rcls/monitor/clocky.kicad_pcb

## KiCad design clocky.kicad_pcb (2025-12-03)

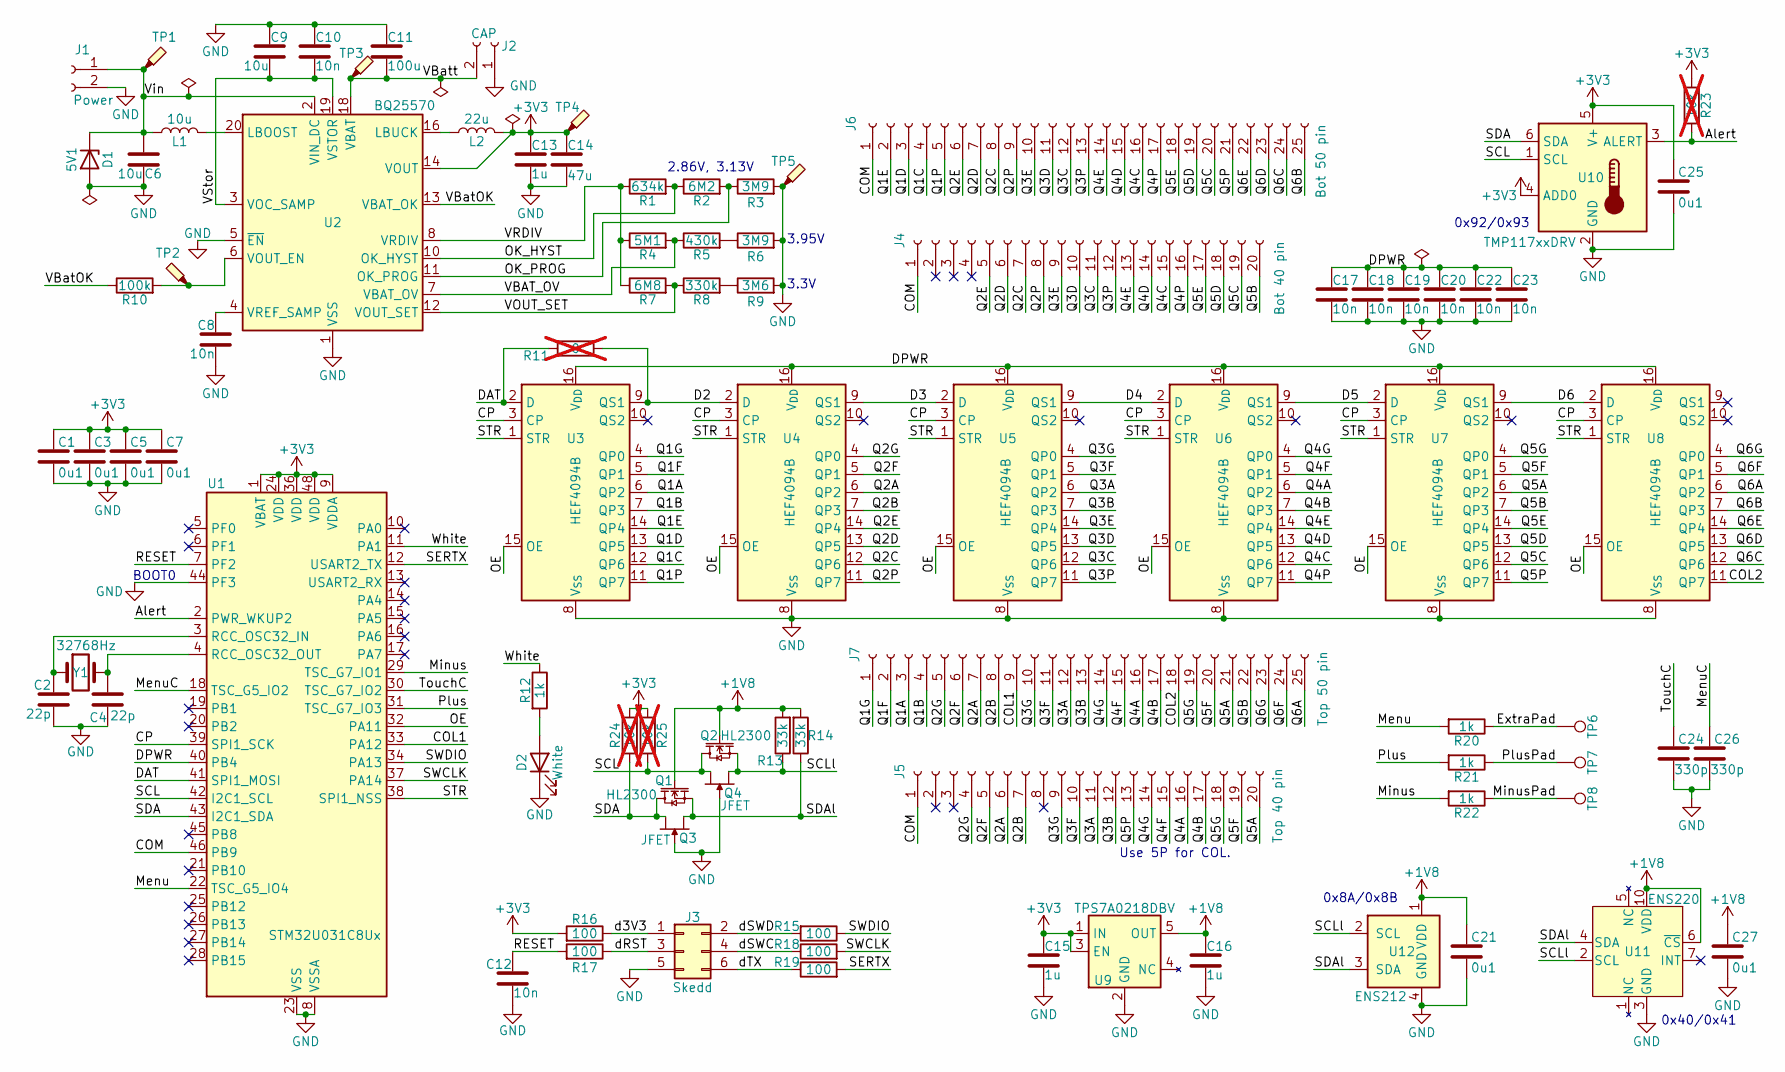
[picture p1: schematic clocky.kicad_sch]

Parts:
C1, C3, C5, C7, C21, C25, C27: 0u1; C_0402_1005Metric; JLCPCB C307331
C2, C4: 22p; C_0402_1005Metric; JLCPCB C1555
C6, C9: 10u; C_0603_1608Metric; JLCPCB C19702
C8, C10, C12, C17, C18, C19, C20, C22, C23: 10n; C_0402_1005Metric; JLCPCB C15195
C11: 100u; C_1206_3216Metric; JLCPCB C15008
C13, C15, C16: 1u; C_0402_1005Metric; JLCPCB C52923
C14: 47u; C_0805_2012Metric; JLCPCB C16780
C24, C26: 330p; C_0402_1005Metric; JLCPCB C13533
D1: 5V1; D_SOD-323; JLCPCB C19077434
D2: White; LED_0603_1608Metric; JLCPCB C2290
J1: Power; PinSocket_1x02_P2.54mm_Vertical
J2: CAP; TwoPin_P3.5mm
J3: Skedd; Skedd6
J4: Bot 40 pin; PinSocket_1x20_P2.54mm_Vertical
J5: Top 40 pin; PinSocket_1x20_P2.54mm_Vertical
J6: Bot 50 pin; PinHeader_1x25_P2.54mm_Vertical
J7: Top 50 pin; PinHeader_1x25_P2.54mm_Vertical
L1: 10u; L_0805_2012Metric_Pad1.05x1.20mm_HandSolder
L2: 22u; L_0805_2012Metric_Pad1.05x1.20mm_HandSolder
Q1, Q2: HL2300; SOT-23; JLCPCB C7420343
Q3, Q4: JFET; SOT-23-3
R1: 634k; R_0603_1608Metric
R2: 6M2; R_0603_1608Metric
R3, R6: 3M9; R_0603_1608Metric
R4: 5M1; R_0603_1608Metric
R5: 430k; R_0603_1608Metric; JLCPCB C25969
R7: 6M8; R_0603_1608Metric
R8: 330k; R_0603_1608Metric; JLCPCB C23137
R9: 3M6; R_0603_1608Metric
R10: 100k; R_0402_1005Metric; JLCPCB C25741
R11: 0; R_0603_1608Metric; not fitted
R12, R20, R21, R22: 1k; R_0402_1005Metric; JLCPCB C11702
R13, R14: 33k; R_0603_1608Metric; JLCPCB C4216
R15, R16, R17, R18, R19: 100; R_0402_1005Metric; JLCPCB C25076
R23, R24, R25: 10k; R_0603_1608Metric; not fitted
TP1, TP2, TP3, TP4, TP5: TestPoint_Probe; TestPoint
TP6, TP7, TP8: TestPoint; Dummy
U1: STM32U031C8Ux; QFN-48-1EP_7x7mm_P0.5mm_EP5.6x5.6mm
U2: BQ25570; QFN-20-1EP_3.5x3.5mm_P0.5mm_EP2x2mm; JLCPCB C506250
U3, U4, U5, U6, U7, U8: HEF4094B; SOIC-16_3.9x9.9mm_P1.27mm
U9: TPS7A0218DBV; SOT-23-5; JLCPCB C3748843
U10: TMP117xxDRV; WSON-6-1EP_2x2mm_P0.65mm_NoEP; JLCPCB C699536
U11: ENS220
U12: ENS212; AMS_QFN-4-1EP_2x2mm_P0.95mm_EP0.7x1.6mm
Y1: 32768Hz; Crystal_SMD_3215-2Pin_3.2x1.5mm; JLCPCB C32346

Connections:
+1V8: C16.1, C21.1, C27.1, Q1.1 (G), Q2.1 (G), R13.2, R14.2, U9.5 (OUT), U11.6 (~CS), U11.10 (VDD), U12.1 (VDD)
+3V3: C1.1, C3.1, C5.1, C7.1, C13.1, C14.1, C15.1, C25.1, L2.2, R16.2, R23.2, R24.2, R25.2, TP4.1, U1.1 (VBAT), U1.9 (VDDA), U1.24 (VDD), U1.36 (VDD), U1.48 (VDD), U2.14 (VOUT), U9.1 (IN), U9.3 (EN), U10.4 (ADD0), U10.5 (V+)
/Alert: R23.1, U1.2 (PWR_WKUP2), U10.3 (ALERT)
/COL1: J7.9, U1.33 (PA12)
/COL2: J7.18, U8.11 (QP7)
/COM: J4.1, J5.1, J6.1, U1.46 (PB9)
/CP: U1.39 (SPI1_SCK), U3.3 (CP), U4.3 (CP), U5.3 (CP), U6.3 (CP), U7.3 (CP), U8.3 (CP)
/D2: R11.2, U3.9 (QS1), U4.2 (D)
/D3: U4.9 (QS1), U5.2 (D)
/D4: U5.9 (QS1), U6.2 (D)
/D5: U6.9 (QS1), U7.2 (D)
/D6: U7.9 (QS1), U8.2 (D)
/DAT: R11.1, U1.41 (SPI1_MOSI), U3.2 (D)
/DPWR: C17.1, C18.1, C19.1, C20.1, C22.1, C23.1, U1.40 (PB4), U3.16 (V_{DD}), U4.16 (V_{DD}), U5.16 (V_{DD}), U6.16 (V_{DD}), U7.16 (V_{DD}), U8.16 (V_{DD})
/ExtraPad: R20.1, TP6.1
/Menu: R20.2, U1.22 (TSC_G5_IO4)
/MenuC: C26.1, U1.18 (TSC_G5_IO2)
/Minus: R22.2, U1.29 (TSC_G7_IO1)
/MinusPad: R22.1, TP8.1
/OE: U1.32 (PA11), U3.15 (OE), U4.15 (OE), U5.15 (OE), U6.15 (OE), U7.15 (OE), U8.15 (OE)
/OK_HYST: R1.2, R2.1, U2.10 (OK_HYST)
/OK_PROG: R2.2, R3.1, U2.11 (OK_PROG)
/Plus: R21.2, U1.31 (TSC_G7_IO3)
/PlusPad: R21.1, TP7.1
/Q1A: J7.3, U3.6 (QP2)
/Q1B: J7.4, U3.7 (QP3)
/Q1C: J6.4, U3.12 (QP6)
/Q1D: J6.3, U3.13 (QP5)
/Q1E: J6.2, U3.14 (QP4)
/Q1F: J7.2, U3.5 (QP1)
/Q1G: J7.1, U3.4 (QP0)
/Q1P: J6.5, U3.11 (QP7)
/Q2A: J5.6, J7.7, U4.6 (QP2)
/Q2B: J5.7, J7.8, U4.7 (QP3)
/Q2C: J4.7, J6.8, U4.12 (QP6)
/Q2D: J4.6, J6.7, U4.13 (QP5)
/Q2E: J4.5, J6.6, U4.14 (QP4)
/Q2F: J5.5, J7.6, U4.5 (QP1)
/Q2G: J5.4, J7.5, U4.4 (QP0)
/Q2P: J4.8, J6.9, U4.11 (QP7)
/Q3A: J5.11, J7.12, U5.6 (QP2)
/Q3B: J5.12, J7.13, U5.7 (QP3)
/Q3C: J4.11, J6.12, U5.12 (QP6)
/Q3D: J4.10, J6.11, U5.13 (QP5)
/Q3E: J4.9, J6.10, U5.14 (QP4)
/Q3F: J5.10, J7.11, U5.5 (QP1)
/Q3G: J5.9, J7.10, U5.4 (QP0)
/Q3P: J4.12, J6.13, U5.11 (QP7)
/Q4A: J5.16, J7.16, U6.6 (QP2)
/Q4B: J5.17, J7.17, U6.7 (QP3)
/Q4C: J4.15, J6.16, U6.12 (QP6)
/Q4D: J4.14, J6.15, U6.13 (QP5)
/Q4E: J4.13, J6.14, U6.14 (QP4)
/Q4F: J5.15, J7.15, U6.5 (QP1)
/Q4G: J5.14, J7.14, U6.4 (QP0)
/Q4P: J4.16, J6.17, U6.11 (QP7)
/Q5A: J5.20, J7.21, U7.6 (QP2)
/Q5B: J4.20, J7.22, U7.7 (QP3)
/Q5C: J4.19, J6.20, U7.12 (QP6)
/Q5D: J4.18, J6.19, U7.13 (QP5)
/Q5E: J4.17, J6.18, U7.14 (QP4)
/Q5F: J5.19, J7.20, U7.5 (QP1)
/Q5G: J5.18, J7.19, U7.4 (QP0)
/Q5P: J5.13, J6.21, U7.11 (QP7)
/Q6A: J7.25, U8.6 (QP2)
/Q6B: J6.25, U8.7 (QP3)
/Q6C: J6.24, U8.12 (QP6)
/Q6D: J6.23, U8.13 (QP5)
/Q6E: J6.22, U8.14 (QP4)
/Q6F: J7.24, U8.5 (QP1)
/Q6G: J7.23, U8.4 (QP0)
/RESET: C12.1, R17.2, U1.7 (PF2)
/SCL: Q2.3 (D), Q4.2 (S), R25.1, U1.42 (I2C1_SCL), U10.1 (SCL)
/SCLl: Q2.2 (S), Q4.1 (D), R13.1, U11.2 (SCL), U12.2 (SCL)
/SDA: Q1.3 (D), Q3.1 (D), R24.1, U1.43 (I2C1_SDA), U10.6 (SDA)
/SDAl: Q1.2 (S), Q3.2 (S), R14.1, U11.4 (SDA), U12.3 (SDA)
/SERTX: R19.2, U1.12 (USART2_TX)
/STR: U1.38 (SPI1_NSS), U3.1 (STR), U4.1 (STR), U5.1 (STR), U6.1 (STR), U7.1 (STR), U8.1 (STR)
/SWCLK: R18.2, U1.37 (PA14)
/SWDIO: R15.1, U1.34 (PA13)
/TouchC: C24.1, U1.30 (TSC_G7_IO2)
/VBAT_OV: R4.2, R5.1, U2.7 (VBAT_OV)
/VBatOK: R10.1, U2.13 (VBAT_OK)
/VBatt: C11.2, J2.2, TP3.1, U2.18 (VBAT)
/VOUT_SET: R7.2, R8.1, U2.12 (VOUT_SET)
/VRDIV: R1.1, R4.1, R7.1, U2.8 (VRDIV)
/VStor: C9.2, C10.2, U2.3 (VOC_SAMP), U2.19 (VSTOR)
/Vin: C6.1, D1.1 (K), J1.1, L1.1, TP1.1, U2.2 (VIN_DC)
/White: R12.1, U1.11 (PA1)
/d3V3: J3.1, R16.1
/dRST: J3.3, R17.1
/dSWC: J3.4, R18.1
/dSWD: J3.2, R15.2
/dTX: J3.6, R19.1
GND: C1.2, C2.2, C3.2, C4.2, C5.2, C6.2, C7.2, C8.2, C9.1, C10.1, C11.1, C12.2, C13.2, C14.2, C15.2, C16.2, C17.2, C18.2, C19.2, C20.2, C21.2, C22.2, C23.2, C24.2, C25.2, C26.2, C27.2, D1.2 (A), D2.1 (K), J1.2, J2.1, J3.5, Q3.3 (G), Q4.3 (G), R3.2, R6.2, R9.2, TP5.1, U1.8 (VSSA), U1.23 (VSS), U1.35 (VSS), U1.44 (PF3), U1.47 (VSS), U1.49 (VSS), U2.1 (VSS), U2.5 (~EN), U2.9 (VSS), U2.15 (VSS), U2.17 (VSS), U2.21 (VSS), U3.8 (V_{SS}), U4.8 (V_{SS}), U5.8 (V_{SS}), U6.8 (V_{SS}), U7.8 (V_{SS}), U8.8 (V_{SS}), U9.2 (GND), U10.2 (GND), U11.3 (GND), U11.8 (GND), U11.9 (GND), U12.4 (GND), U12.5 (GND)
unnamed: D2.2 (A), R12.2
unnamed: R5.2, R6.1
unnamed: R8.2, R9.1
unnamed: C2.1, U1.3 (RCC_OSC32_IN), Y1.1
unnamed: C4.1, U1.4 (RCC_OSC32_OUT), Y1.2
unnamed: L1.2, U2.20 (LBOOST)
unnamed: L2.1, U2.16 (LBUCK)
unnamed: R10.2, TP2.1, U2.6 (VOUT_EN)
unnamed: C8.1, U2.4 (VREF_SAMP)

Notes on the sheet:
3.95V
3.3V
0x8A/0x8B
BOOT0
2.86V, 3.13V
0x40/0x41
Use 5P for COL.
0x92/0x93

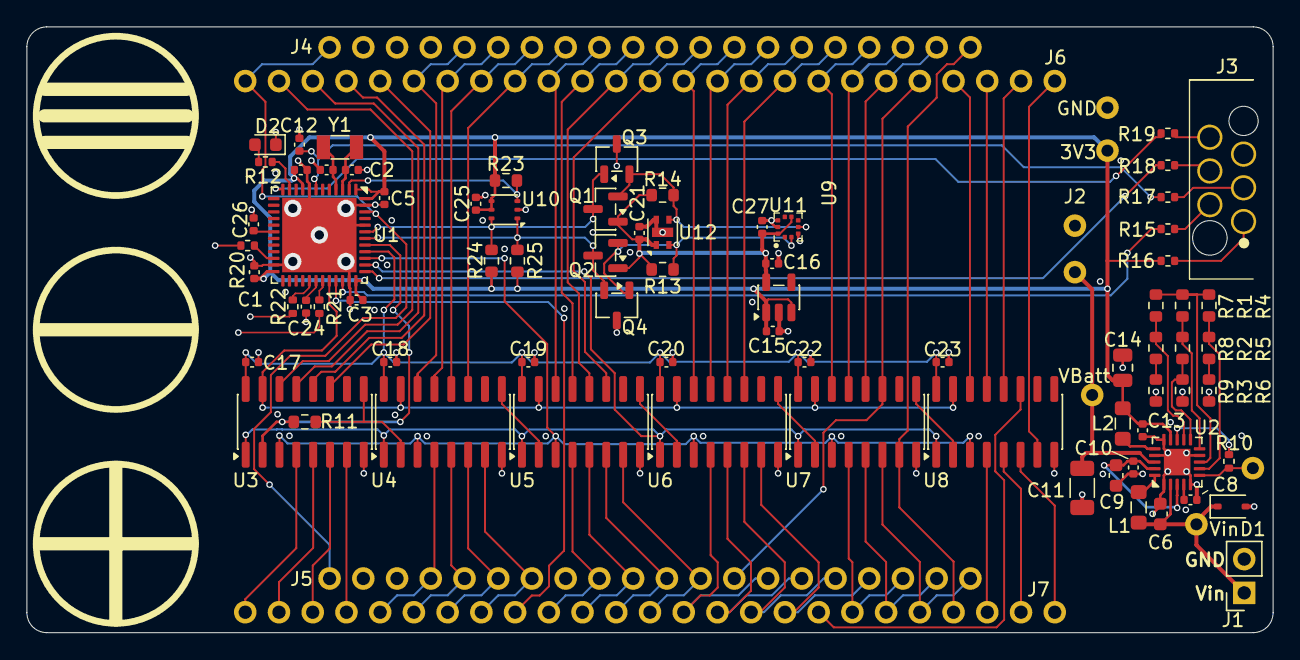
[picture p2: board clocky.kicad_pcb from above]

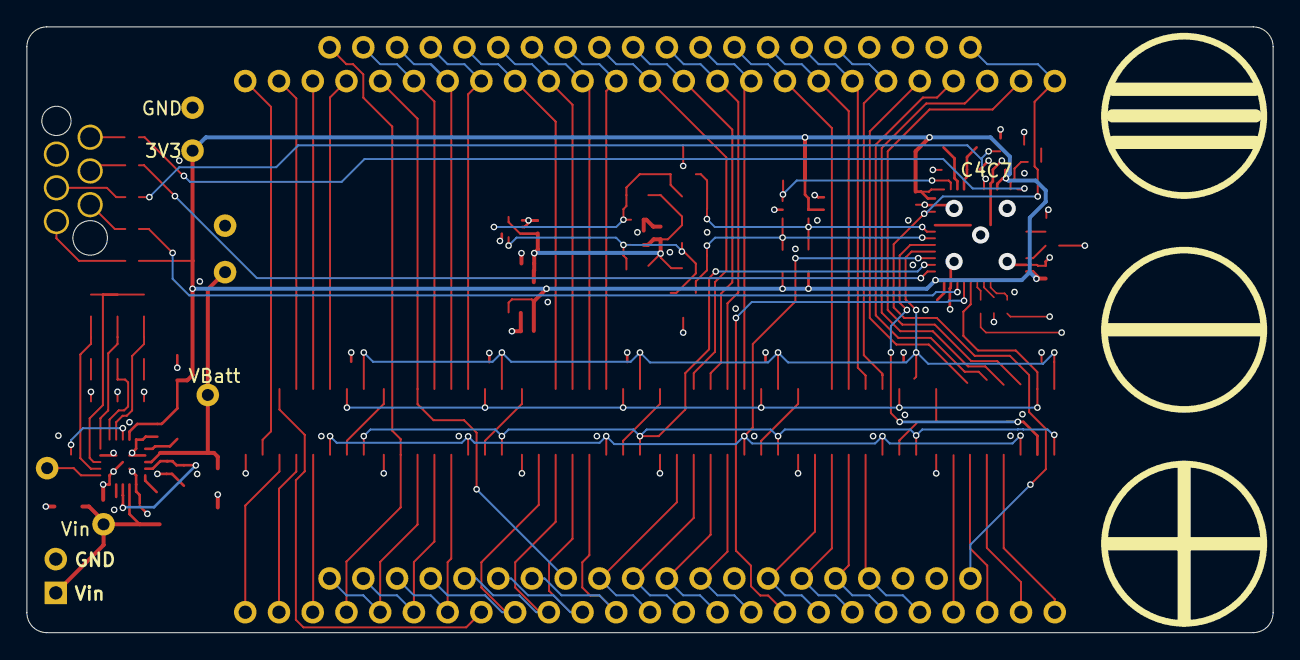
[picture p3: board clocky.kicad_pcb from below]

Board: 4 copper layers, 93.9 x 45.6 mm, 88 parts (5 on the bottom side), 104 nets.
