rcls/monitor/monitor.kicad_pcb

## KiCad design monitor.kicad_pcb (2025-07-09)

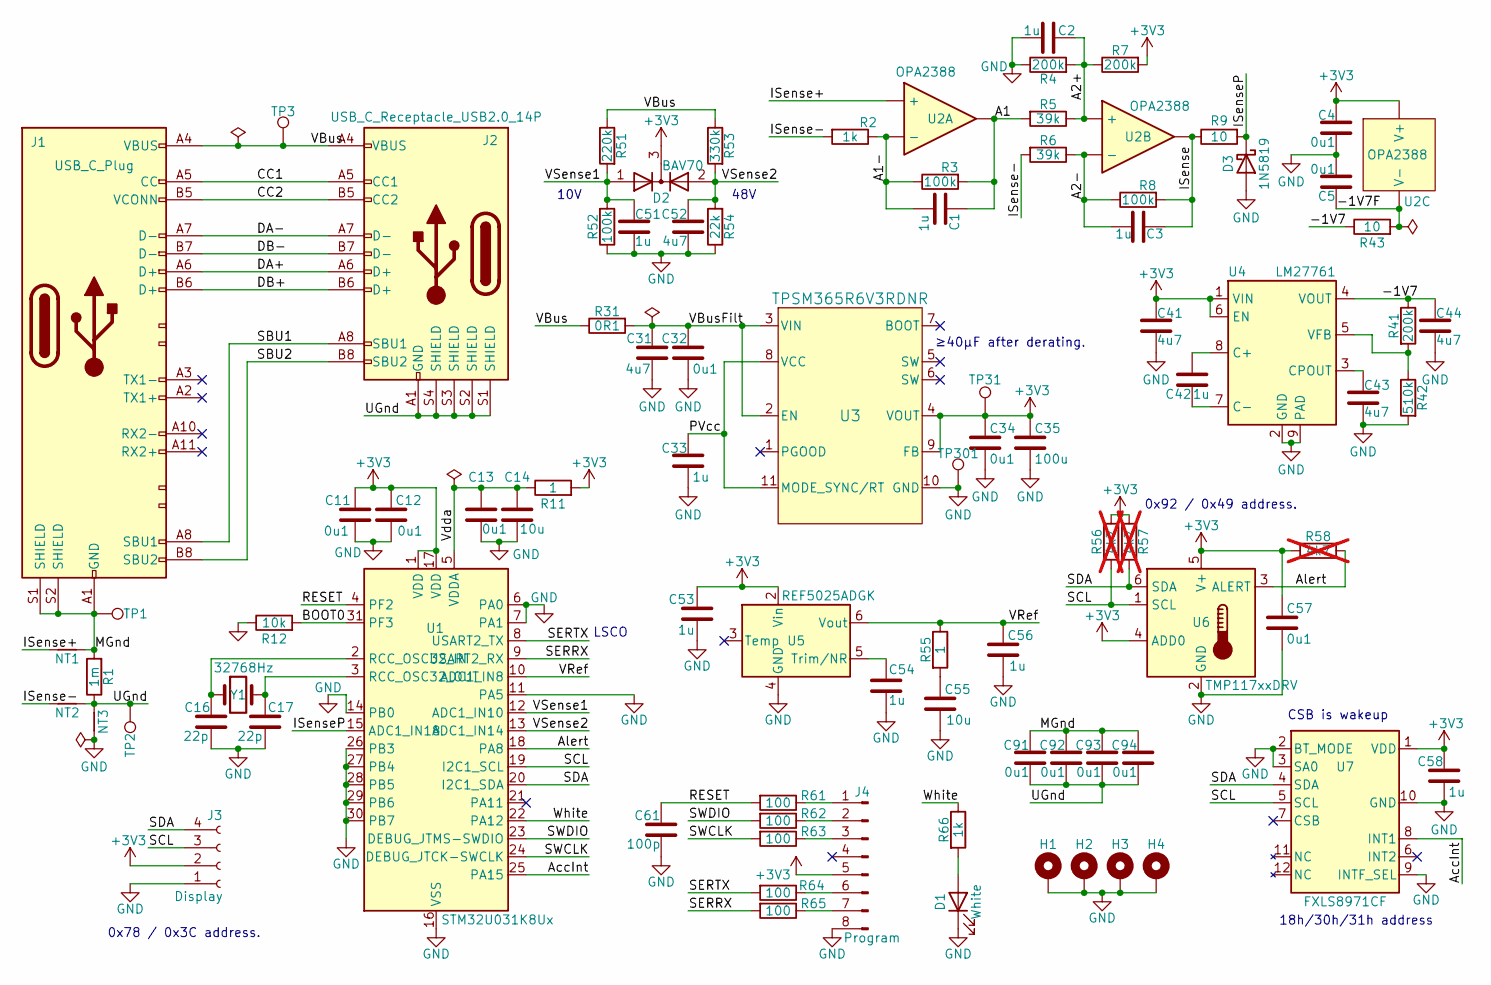
[picture p4: schematic monitor.kicad_sch]

Parts:
C1, C2, C3, C33, C42, C51, C53, C54, C56, C58: 1u; C_0402_1005Metric; JLCPCB C52923
C4, C5, C11, C12, C13, C32, C34, C57: 0u1; C_0402_1005Metric; JLCPCB C307331
C14, C55: 10u; C_0402_1005Metric; JLCPCB C15525
C16, C17: 22p; C_0402_1005Metric; JLCPCB C1555
C31: 4u7; C_1206_3216Metric; JLCPCB C29823
C35: 100u; C_1206_3216Metric; JLCPCB C15008
C41, C43, C44, C52: 4u7; C_0402_1005Metric; JLCPCB C23733
C61: 100p; C_0402_1005Metric; JLCPCB C1546
C91, C92, C93, C94: 0u1; C_0402_1005Metric
D1: White; LED_0603_1608Metric; JLCPCB C2290
D2: BAV70; SOT-23; JLCPCB C68978
D3: 1N5819; D_SOD-323; JLCPCB C191023
H1, H2, H3, H4: MountingHole_Pad; MountingHole_3mm_Pad
J1: USB_C_Plug; USB-C-male-24-Ass
J2: USB_C_Receptacle_USB2.0_14P; USB_C_Receptacle_16P
J3: Display; JST_XH_B4B-XH-A_1x04_P2.50mm_Vertical
J4: Program; PinHeader_1x08_P2.54mm_Vertical
NT1, NT2: NetTie_2; NetTie-2_0.2mm
NT3: NetTie_2; NetTie-2_SMD_Pad0.5mm
R1: 1m; R_1206_3216Metric
R2: 1k; R_0603_1608Metric; JLCPCB C21190
R3, R8, R52: 100k; R_0603_1608Metric; JLCPCB C25803
R4, R7: 200k; R_0603_1608Metric; JLCPCB C25811
R5, R6: 39k; R_0603_1608Metric; JLCPCB C23153
R9, R43: 10; R_0402_1005Metric; JLCPCB C25077
R11, R55: 1; R_0402_1005Metric; JLCPCB C25086
R12: 10k; R_0402_1005Metric; JLCPCB C25744
R31: 0R1; R_0603_1608Metric
R41: 200k; R_0402_1005Metric; JLCPCB C25764
R42: 510k; R_0402_1005Metric; JLCPCB C11616
R51: 220k; R_0603_1608Metric; JLCPCB C22961
R53: 330k; R_0603_1608Metric; JLCPCB C23137
R54: 22k; R_0603_1608Metric; JLCPCB C31850
R56, R57, R58: 4k7; R_0603_1608Metric; not fitted
R61, R62, R63, R64, R65: 100; R_0402_1005Metric; JLCPCB C25076
R66: 1k; R_0402_1005Metric; JLCPCB C11702
TP1, TP2, TP3, TP31, TP301: TestPoint
U1: STM32U031K8Ux; QFN-32-1EP_5x5mm_P0.5mm_EP3.45x3.45mm; JLCPCB C22445362
U2: OPA2388; MSOP-8_3x3mm_P0.65mm; JLCPCB C2059281
U3: TPSM365R6V3RDNR; RDN0011A-MFG; JLCPCB C18208843
U4: LM27761; WSON-8-1EP_2x2mm_P0.5mm_EP0.9x1.6mm; JLCPCB C129351
U5: REF5025ADGK; MSOP-8_3x3mm_P0.65mm; JLCPCB C75881
U6: TMP117xxDRV; WSON-6-1EP_2x2mm_P0.65mm_NoEP; JLCPCB C699536
U7: FXLS8971CF; JLCPCB C24123558
Y1: 32768Hz; Crystal_SMD_3215-2Pin_3.2x1.5mm; JLCPCB C32346

Connections:
+3V3: C4.1, C11.1, C12.1, C34.1, C35.1, C41.1, C53.1, C57.1, C58.1, D2.3 (K), J3.2, J4.5, R7.2, R11.2, R56.1, R57.1, R58.1, TP31.1, U1.1 (VDD), U1.17 (VDD), U2.8 (V+), U3.4 (VOUT), U3.9 (FB), U4.1 (VIN), U4.6 (EN), U5.2 (Vin), U6.4 (ADD0), U6.5 (V+), U7.1 (VDD)
/-1V7: C44.1, R41.1, R43.1, U4.4 (VOUT)
/-1V7F: C5.2, R43.2, U2.4 (V-)
/A1: C1.1, R3.2, R5.2, U2.1
/A1-: C1.2, R2.1, R3.1, U2.2 (-)
/A2+: C2.1, R4.2, R5.1, R7.1, U2.5 (+)
/A2-: C3.2, R6.1, R8.1, U2.6 (-)
/AccInt: U1.25 (PA15), U7.8 (INT1)
/Alert: R58.2, U1.18 (PA8), U6.3 (ALERT)
/BOOT0: R12.2, U1.31 (PF3)
/CC1: J1.A5 (CC), J2.A5 (CC1)
/CC2: J1.B5 (VCONN), J2.B5 (CC2)
/DA+: J1.A6 (D+), J2.A6 (D+)
/DA-: J1.A7 (D-), J2.A7 (D-)
/DB+: J1.B6 (D+), J2.B6 (D+)
/DB-: J1.B7 (D-), J2.B7 (D-)
/ISense: C3.1, R8.2, R9.1, U2.7
/ISense+: NT1.2, U2.3 (+)
/ISense-: NT2.2, R2.2, R6.2
/ISenseP: D3.1 (K), R9.2, U1.15 (ADC1_IN18)
/MGnd: C91.1, C92.1, C93.1, C94.1, J1.A1 (GND), J1.A12 (GND), J1.B1 (GND), J1.B12 (GND), J1.S1 (SHIELD), J1.S2 (SHIELD), NT1.1, R1.2, TP1.1
/PVcc: C33.1, U3.8 (VCC), U3.11 (MODE_SYNC/RT)
/RESET: C61.1, R61.2, U1.4 (PF2)
/SBU1: J1.A8 (SBU1), J2.A8 (SBU1)
/SBU2: J1.B8 (SBU2), J2.B8 (SBU2)
/SCL: J3.3, R56.2, U1.19 (I2C1_SCL), U6.1 (SCL), U7.5 (SCL)
/SDA: J3.4, R57.2, U1.20 (I2C1_SDA), U6.6 (SDA), U7.4 (SDA)
/SERRX: R65.2, U1.9 (USART2_RX)
/SERTX: R64.2, U1.8 (USART2_TX)
/SWCLK: R63.2, U1.24 (DEBUG_JTCK-SWCLK)
/SWDIO: R62.2, U1.23 (DEBUG_JTMS-SWDIO)
/UGnd: C91.2, C92.2, C93.2, C94.2, J2.A1 (GND), J2.A12 (GND), J2.B1 (GND), J2.B12 (GND), J2.S1 (SHIELD), J2.S2 (SHIELD), J2.S3 (SHIELD), J2.S4 (SHIELD), NT2.1, NT3.2, R1.1, TP2.1
/VBus: J1.A4 (VBUS), J1.A9 (VBUS), J1.B4 (VBUS), J1.B9 (VBUS), J2.A4 (VBUS), J2.A9 (VBUS), J2.B4 (VBUS), J2.B9 (VBUS), R31.1, R51.1, R53.1, TP3.1
/VBusFilt: C31.1, C32.1, R31.2, U3.2 (EN), U3.3 (VIN)
/VRef: C56.1, R55.1, U1.10 (ADC1_IN8), U5.6 (Vout)
/VSense1: C51.1, D2.1 (A), R51.2, R52.2, U1.12 (ADC1_IN10)
/VSense2: C52.1, D2.2 (A), R53.2, R54.2, U1.13 (ADC1_IN14)
/Vdda: C13.1, C14.1, R11.1, U1.5 (VDDA)
/White: R66.1, U1.22 (PA12)
GND: C2.2, C4.2, C5.1, C11.2, C12.2, C13.2, C14.2, C16.2, C17.2, C31.2, C32.2, C33.2, C34.2, C35.2, C41.2, C43.2, C44.2, C51.2, C52.2, C53.2, C54.2, C55.2, C56.2, C57.2, C58.2, C61.2, D1.1 (K), D3.2 (A), H1.1, H2.1, H3.1, H4.1, J3.1, J4.8, NT3.1, R4.1, R12.1, R42.2, R52.1, R54.1, TP301.1, U1.6 (PA0), U1.7 (PA1), U1.11 (PA5), U1.14 (PB0), U1.16 (VSS), U1.26 (PB3), U1.27 (PB4), U1.28 (PB5), U1.29 (PB6), U1.30 (PB7), U1.32 (VSS), U1.33 (VSS), U3.10 (GND), U4.2 (GND), U4.9 (PAD), U5.4 (GND), U6.2 (GND), U7.2 (BT_MODE), U7.3 (SA0), U7.9 (INTF_SEL), U7.10 (GND)
unnamed: C55.1, R55.2
unnamed: D1.2 (A), R66.2
unnamed: J4.1, R61.1
unnamed: J4.2, R62.1
unnamed: J4.3, R63.1
unnamed: J4.6, R64.1
unnamed: J4.7, R65.1
unnamed: C16.1, U1.2 (RCC_OSC32_IN), Y1.1
unnamed: C17.1, U1.3 (RCC_OSC32_OUT), Y1.2
unnamed: C42.1, U4.8 (C+)
unnamed: C42.2, U4.7 (C-)
unnamed: C43.1, U4.3 (CPOUT)
unnamed: R41.2, R42.1, U4.5 (VFB)
unnamed: C54.1, U5.5 (Trim/NR)

Notes on the sheet:
0x92 / 0x49 address.
18h/30h/31h address
LSCO
≥40µF after derating.
48V
CSB is wakeup
10V
0x78 / 0x3C address.

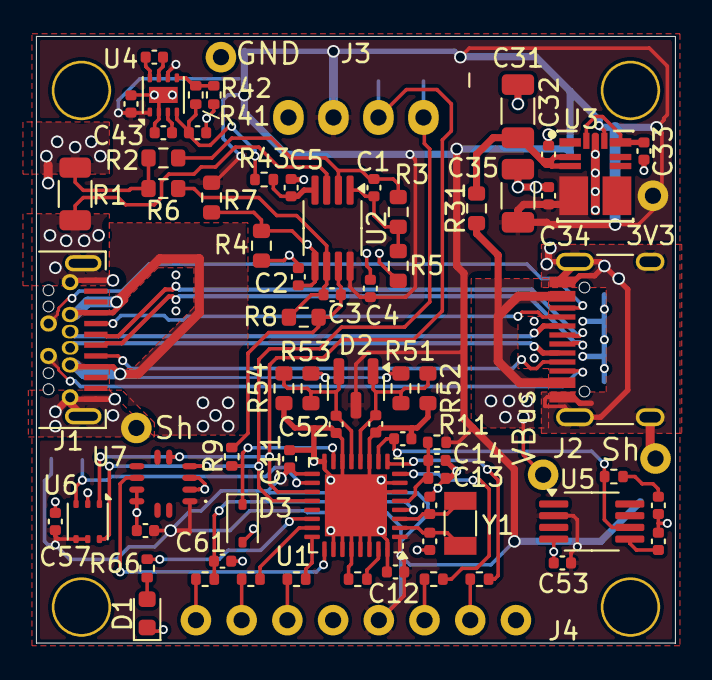
[picture p5: board monitor.kicad_pcb from above]

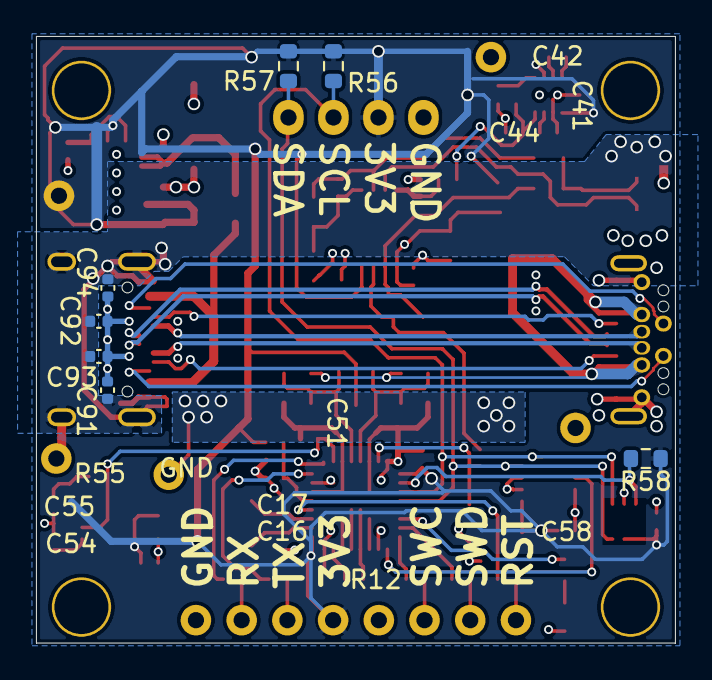
[picture p6: board monitor.kicad_pcb from below]

Board: 4 copper layers, 35.5 x 33.7 mm, 89 parts (11 on the bottom side), 54 nets.
