rcls/monitor/src/clocky.rs

use stm_common::{i2c::Result, vcell::UCell};

use crate::*;

mod date_time;
mod display;
mod touch;

pub const DEBUG_ENABLE: bool = !crate::CONFIG.no_debug;

pub fn debug_fmt(fmt: core::fmt::Arguments) {
    if DEBUG_ENABLE {
        stm_common::debug::debug_fmt::<debug::DebugMeta>(fmt);
    }
}

pub const CONFIG: cpu::Config = {
    let mut cfg = cpu::Config::new(2000000);
    cfg.pullup |= 1 << 0x2d;
    cfg.standby_pu |= 1 << 0x2d; // PC13, the TMP117 alert.
    cfg.fll = false;
    *cfg.no_debug().lazy_i2c().lcd().rtc().lazy_tsc()};

const MAGIC: u32 = 0xd6ea33e;

pub const I2C_LINES: i2c::I2CLines = i2c::I2CLines::B6_B7;

/// Power of two factor of the 256Hz RTC clock to use for the main tick.
const TICKS_PER_SEC: u32 = 8;
const ALARM_BITS: u8 = 8 - TICKS_PER_SEC.ilog2() as u8;

/// The overall system state, taking just 9 32-bit words.
#[repr(C)]
#[derive(Default)]
struct System {
    /// Magic number.
    magic: u32,
    /// State enumeration in low 16 bits, sub-state in high 16 bits.
    states: u32,
    /// Temperature in tenths of °C.
    temp: i32,
    /// Humidity or ~0 for no sensor.
    humidity: u32,
    /// Current touch state in low byte. 0:None, 1:+, 2:-, 3:≡
    /// Touch timer in upper 16 bits. Down counter running while touch system
    /// activated.
    touches: u32,
    /// Unused.
    unused: u32,
    /// Stored touch information for debugging / calibration.
    touch_debug: u32,
    /// Pressure in 1/64 Pa, or ~0 for no sensor.
    pressure: u32,
    /// Stored address before crash & reboot.
    crash: u32,
}
const _: () = assert!(size_of::<System>() == 36);

/// Main display state.
#[allow(dead_code)]
#[repr(u8)]
#[derive(Clone, Copy, PartialEq, Eq, PartialOrd)]
enum State {
    Temp = 0,
    Pres = 1,
    Humi = 2,
    Time = 3,
    Date = 4,
    Conf = 5,
}

/// Config substates.
mod conf {
    /// Clock calibration.
    pub const CALIB: u32 = 1;
    /// Crystal drive stength.
    pub const DRIVE: u32 = 2;
    /// Crash address.
    pub const CRASH: u32 = 3;
    /// Touch panel evaluation.
    pub const TOUCH: u32 = 4;
    pub const MAX  : u32 = 4;
}

impl State {
    const MIN: State = State::Temp;
    const MAX: State = State::Conf;

    fn next(self) -> State {
        if self < State::MAX {
            unsafe {core::mem::transmute(self as u8 + 1)}
        }
        else {
            State::MIN
        }
    }
    fn prev(self) -> State {
        if self > State::MIN {
            unsafe {core::mem::transmute(self as u8 - 1)}
        }
        else {
            State::MAX
        }
    }
}

impl System {
    unsafe fn get() -> &'static mut Self {
        let tamp = unsafe {&*stm32u031::TAMP::ptr()};
        let p = tamp.BKPR[0].as_ptr() as *const UCell<System>;
        let sys = unsafe {(&*p).as_mut()};
        // Validate fields.
        if sys.states & 0xffff > State::MAX as u32 {
            sys.states = State::Temp as u32;
        }
        sys
    }

    fn init(&mut self) {
        self.magic    = MAGIC;
        self.states   &= 0xffff;
        self.temp     = self.temp.clamp(-1999, 1999);
        self.touches  = 0;
        self.unused   = 0;
        self.pressure = !0;
        self.humidity = !0;
    }

    fn state(&self) -> State {
        // SAFETY: We sanitize this at each wake-up.
        unsafe {core::mem::transmute(self.states as u8)}
    }

    fn set_state(&mut self, state: State, sub_state: u32) {
        self.states = state as u32 | sub_state << 16;
        set_state_hook(self, state, sub_state);
    }

    fn sub_state(&self) -> u32 {self.states >> 16}

    fn touch(&self) -> u32 {self.touches & 0xffff}
    fn touch_timer(&self) -> u32 {self.touches >> 16}
    fn set_touch(&mut self, touch: u32, timer: u32) {
        self.touches = timer * 65536 + touch;
    }

    fn pressure(&self) -> u32 {self.pressure & 0x00ffffff}
    fn set_pressure(&mut self, pressure: u32) {
        self.pressure = self.pressure & 0x7f000000 | pressure;
    }
    fn set_no_pressure(&mut self) {
        self.pressure = !0;
    }
    fn pressure_point(&self) -> u32 {
        (self.pressure >> 24 & 127).min(6 - LCD_WIDTH)
    }
    fn set_pressure_point(&mut self, point: u32) {
        self.pressure = self.pressure & 0x80ffffff | point << 24
    }

    fn have_pressure(&self) -> bool {self.pressure < 0x80000000}
    fn have_humidity(&self) -> bool {self.humidity < 0x80000000}
}

fn cold_start(sys: &mut System) {
    let pwr = unsafe {&*stm32u031::PWR::ptr()};
    // Enable RTC wakeup.  (It should already be enabled).  The TMP117 alert
    // is on PC13, wake-up 2, enable that.
    pwr.CR3.write(|w| w.APC().set_bit().EIWUL().set_bit().EWUP2().set_bit());
    // Clear the wake-up pin now as it has probably gotten set during start-up.
    // We will trigger a temperature conversion immediately, and
    pwr.SCR.write(|w| w.CWUF2().set_bit());

    // Turn on the VBATT charging.  Set the wakeup 2 polarity at the same time.
    pwr.CR4.write(|w| w.VBE().set_bit().VBRS().set_bit().WP2().set_bit());

    i2c::init();

    debug::banner("**** CLOCKY 0x", sys.crash, " ****\n");

    sys.init();

    // Wait a few ms.
    for _ in 0 .. CONFIG.clk / 500 {
        stm_common::utils::nothing();
    }

    tmp117::init();

    rtc::ensure_options();
    rtc_setup_tick();

    if let Ok(humidity) = ens212::init() {
        sys.humidity = humidity;
    }

    if let Ok(pressure) = ens220::init() {
        sys.set_pressure(pressure);
    }
}

fn rtc_setup_tick() {
    rtc::setup_start();

    const {assert!(TICKS_PER_SEC == 1 << 8 - ALARM_BITS)};

    // Set the alarm A to fire (8>>bits) times / sec.
    let rtc = unsafe {&*stm32u031::RTC::ptr()};
    rtc.CR.write(|w| w.ALRAE().clear_bit());

    rtc.ALRMAR.write(|w| w.bits(!0));
    rtc.ALRMASSR.write(
        |w| w.MASKSS().bits(ALARM_BITS).SS().bits((1 << ALARM_BITS) - 1));

    rtc.CR.write(
        |w| w.ALRAE().set_bit().ALRAIE().set_bit().BYPSHAD().set_bit());
    rtc::relock();
}

fn rtc_adjust(item: u32, forwards: bool) {
    rtc::init_start();
    let rtc = unsafe {&*stm32u031::RTC::ptr()};
    if item < 3 {
        let t = date_time::adjust_time(item, rtc.TR.read().bits(), forwards);
        rtc.TR.write(|w| w.bits(t));
    }
    else {
        let d = date_time::adjust_date(item, rtc.DR.read().bits(), forwards);
        rtc.DR.write(|w| w.bits(d));
    }
    rtc::init_end();
}

fn cal_plus_minus(sys: &mut System, is_plus: bool) {
    let rcc = unsafe {&*stm32u031::RCC::ptr()};
    match sys.sub_state() {
        conf::CALIB => {
            let cal = rtc::get_cal();
            rtc::set_cal(
                if is_plus {cal.min(98) + 1} else {cal.max(-98) - 1});
        }
        conf::DRIVE => {
            let bdcr = rcc.BDCR.read();
            let d = bdcr.LSEDRV().bits();
            let d = if is_plus {d.min(2) + 1} else {d.max(2) - 1};
            rcc.BDCR.write(|w| w.bits(bdcr.bits()).LSEDRV().bits(d));
        }
        conf::TOUCH => sys.touch_debug |= 0x80000000,
        _ => (),
    }
}

fn set_state_hook(sys: &mut System, state: State, sub_state: u32) {
    // Update the cal clock output.
    let rcc = unsafe {&*stm32u031::RCC::ptr()};
    if state == State::Conf && sub_state != 0 {
        rcc.BDCR.modify(
            |_, w| w.LSCOSEL().set_bit().LSCOEN().set_bit().LSESYSEN().set_bit());
    }
    else if state != State::Conf {
        // FIXME - what happens if we take a real system reset with the LSCO
        // active?
        rcc.BDCR.modify(|_, w| w.LSCOEN().clear_bit().LSESYSEN().clear_bit());
    }

    if state == State::Conf && sub_state == conf::TOUCH {
        // When we enter CONF+TOUCH, make sure we start idle.
        sys.touch_debug &= 0x7fffffff;
    }
}

fn acquire(sys: &mut System, tr: u32, ssr: u32)
        -> (i2c::Wait<'static>, fn(&mut System, Result)) {
    // At each second, acquire the current displayed item, if any.
    // Otherwise, just past the top of the minute, trigger a conversion of
    // something, round-robin.
    let state = sys.state();

    let ssr = (!ssr & 0xff) >> ALARM_BITS;
    let item = tr & 0x3ff;

    if if state == State::Temp {ssr == 0} else {item == 0 && ssr == 2} {
        return (tmp117::acquire(), dummy_handler);
    }

    if if state == State::Humi {ssr == 0} else {item == 0x100 && ssr == 2} {
        return (ens212::start(), ens212_start_done);
    }

    // TODO - is one tick long enough?
    if if state == State::Humi {ssr == 1} else {item == 0x100 && ssr == 3} {
        return (ens212::get(), ens212_get_done);
    }

    if if state == State::Pres {ssr == 0} else {item == 0x300 && ssr == 2} {
        return (ens220::start(), ens220_start_done);
    }

    if ssr == 2 + TICKS_PER_SEC / 4 && (state == State::Pres || item == 0x300) {
        return (ens220::get(), ens220_get_done);
    }

    (i2c::Wait::default(), dummy_handler)
}

fn ens212_start_done(sys: &mut System, ok: Result) {
    if ok.is_err() {
        sys.humidity = !0;
    }
}

fn ens212_get_done(sys: &mut System, ok: Result) {
    sys.humidity = if ok.is_ok() {ens212::get_humidity()} else {!0};
}

fn ens220_start_done(sys: &mut System, ok: Result) {
    if ok.is_err() {
        sys.set_no_pressure();
    }
}

fn ens220_get_done(sys: &mut System, ok: Result) {
    if ok.is_ok() {
        sys.set_pressure(ens220::get_pressure());
    }
    else {
        sys.set_no_pressure();
    }
}

fn dummy_handler(_: &mut System, ok: Result) {
    if let Err(_err) = ok {
        // dbgln!("I2C failed {_err:?}");
    }
}

fn tick(sys: &mut System) {
    let rtc = unsafe {&*stm32u031::RTC::ptr()};

    let sr = rtc.MISR.read();
    rtc.SCR.write(|w| w.bits(sr.bits()));

    let ssr = rtc.SSR.read().bits();

    let (wait, handler) = acquire(sys, rtc.TR.read().bits(), ssr);

    let do_touch = sys.touch_timer() != 0 || ssr & 0x70 == 0x70;
    if do_touch {
        tsc::init();
        tsc::acquire();
    }

    lcd::init();
    let segments = display::get_segments(sys);
    lcd::update_lcd(segments, ssr & 1 << ALARM_BITS != 0);

    if do_touch {
        touch::process(sys);
    }

    handler(sys, wait.wait());
}

pub fn main() -> ! {
    let gpioa = unsafe {&*stm32u031::GPIOA::ptr()};
    let gpioc = unsafe {&*stm32u031::GPIOC::ptr()};
    let pwr   = unsafe {&*stm32u031::PWR  ::ptr()};
    let rcc   = unsafe {&*stm32u031::RCC  ::ptr()};
    let sys   = unsafe {System::get()};

    // Enable IO clocks.
    rcc.IOPENR.write(
        |w| w.GPIOAEN().set_bit().GPIOBEN().set_bit().GPIOCEN().set_bit());

    if rcc.BDCR.read().LSCOEN().bit() {
        // Set PA1 (the LED) as output high.
        gpioa.BSRR.write(|w| w.BS1().set_bit());
        gpioa.MODER.modify(|_, w| w.MODE1().B_0x1());
    }

    cpu::init1();
    cpu::init2();

    if DEBUG_ENABLE {
        if !CONFIG.is_lazy_debug() {
            debug::init();
        }
        unsafe {stm_common::set_debug_handler(Some(debug_fmt))};
    }

    // Set the TMP117 alert pin as input.
    gpioc.MODER.modify(|_, w| w.MODE13().B_0x0());

    let rcc_csr = rcc.CSR.read().bits();

    let sr1 = pwr.SR1.read();

    // If all of the reset reason, the magic number, and the woke-from-standby
    // flag agree, treat this as a normal restart.  Else do a cold-start.
    if rcc_csr & 0xfe000000 != 0 || sys.magic != MAGIC
        || !sr1.SBF().bit() {
        cold_start(sys);
    }

    let mut lcd_update = false;
    // Wake-up 2 / PC13 is the TMP117 alert, active low.  We test the GPIO state
    // rather than the wake-up flag, so that a lost edge on the alert pin
    // doesn't hang the temperature reading.
    if sr1.WUF2().bit() || !gpioc.IDR.read().ID13().bit() {
        pwr.SCR.write(|w| w.CWUF2().set_bit());
        sys.temp = tmp117::alert();
    }

    if sr1.WUFI().bit() {
        tick(sys);
        lcd_update = true;
    }

    rtc::standby(lcd_update);
}
