rcls/monitor/src/font.rs

#![allow(dead_code, non_upper_case_globals)]

pub static CHARS: &str = r#" AVWm.°-0123456789"#;

pub const SPACE: u8 = 0;
pub const LETTER_A: u8 = 1;
pub const LETTER_V: u8 = 2;
pub const LETTER_W: u8 = 3;
pub const LETTER_m: u8 = 4;
pub const PERIOD: u8 = 5;
pub const DEGREE: u8 = 6;
pub const MINUS: u8 = 7;
pub const DIGIT_0: u8 = 8;
pub const DIGIT_1: u8 = 9;
pub const DIGIT_2: u8 = 10;
pub const DIGIT_3: u8 = 11;
pub const DIGIT_4: u8 = 12;
pub const DIGIT_5: u8 = 13;
pub const DIGIT_6: u8 = 14;
pub const DIGIT_7: u8 = 15;
pub const DIGIT_8: u8 = 16;
pub const DIGIT_9: u8 = 17;
pub const LEFT_TOP_0: u8 = 18;
pub const LEFT_TOP_1: u8 = 19;
pub const LEFT_TOP_2: u8 = 20;
pub const LEFT_TOP_3: u8 = 21;
pub const LEFT_TOP_4: u8 = 22;
pub const LEFT_TOP_5: u8 = 23;
pub const LEFT_TOP_6: u8 = 24;
pub const LEFT_TOP_7: u8 = 25;
pub const LEFT_BOTTOM_0: u8 = 26;
pub const LEFT_BOTTOM_1: u8 = 27;
pub const LEFT_BOTTOM_2: u8 = 28;
pub const LEFT_BOTTOM_3: u8 = 29;
pub const LEFT_BOTTOM_4: u8 = 30;
pub const LEFT_BOTTOM_5: u8 = 31;
pub const LEFT_BOTTOM_6: u8 = 32;
pub const LEFT_BOTTOM_7: u8 = 33;
pub const RIGHT_TOP_0: u8 = 34;
pub const RIGHT_TOP_1: u8 = 35;
pub const RIGHT_TOP_2: u8 = 36;
pub const RIGHT_TOP_3: u8 = 37;
pub const RIGHT_TOP_4: u8 = 38;
pub const RIGHT_TOP_5: u8 = 39;
pub const RIGHT_TOP_6: u8 = 40;
pub const RIGHT_TOP_7: u8 = 41;
pub const RIGHT_BOTTOM_0: u8 = 42;
pub const RIGHT_BOTTOM_1: u8 = 43;
pub const RIGHT_BOTTOM_2: u8 = 44;
pub const RIGHT_BOTTOM_3: u8 = 45;
pub const RIGHT_BOTTOM_4: u8 = 46;
pub const RIGHT_BOTTOM_5: u8 = 47;
pub const RIGHT_BOTTOM_6: u8 = 48;
pub const RIGHT_BOTTOM_7: u8 = 49;

pub static FONT10X16: [[[u8; 10]; 50]; 2] = [[
        [   0,   0,   0,   0,   0,   0,   0,   0,   0,   0],
        [ 192, 160, 144, 136, 132, 136, 144, 160, 192,   0], // A
        [  28,  96, 128,   0,   0,   0, 128,  96,  28,   0], // V
        [ 252,   0,   0,   0,   0,   0,   0,   0, 252,   0], // W
        [ 192, 128,  64,  64, 128,  64,  64, 128,   0,   0], // m
        [   0,   0,   0,   0,   0,   0,   0,   0,   0,   0], // .
        [ 112, 136,   4,   4,   4, 136, 112,   0,   0,   0], // °
        [   0, 128, 128, 128, 128, 128, 128, 128,   0,   0], // -
        [ 240,   8,   4,   4, 132,   4,   4,   8, 240,   0], // 0
        [   0,  32,  16,   8, 252,   0,   0,   0,   0,   0], // 1
        [  16,   8,   4,   4,   4, 132,  68,  40,  16,   0], // 2
        [  16,   8,   4, 132, 132, 132, 132,  72,  48,   0], // 3
        [   0,   0, 128,  64,  32,  16,   8,   4,   0,   0], // 4
        [ 124,  68,  68,  68,  68,  68,  68, 132,   0,   0], // 5
        [ 112, 136, 132, 132, 132, 132, 132,   8,   0,   0], // 6
        [   4,   4,   4,   4,   4, 132,  68,  36,  28,   0], // 7
        [ 112, 136, 132, 132, 132, 132, 132, 136, 112,   0], // 8
        [  48,  72, 132, 132, 132, 132, 132, 136, 112,   0], // 9
        [ 128, 192,  96,  48,  24,  12,   4,   0, 128, 192], // LEFT_TOP_0
        [ 192,  96,  48,  24,  12,   4,   0, 128, 192,  96], // LEFT_TOP_1
        [  96,  48,  24,  12,   4,   0, 128, 192,  96,  48], // LEFT_TOP_2
        [  48,  24,  12,   4,   0, 128, 192,  96,  48,  24], // LEFT_TOP_3
        [  24,  12,   4,   0, 128, 192,  96,  48,  24,  12], // LEFT_TOP_4
        [  12,   4,   0, 128, 192,  96,  48,  24,  12,   4], // LEFT_TOP_5
        [   4,   0, 128, 192,  96,  48,  24,  12,   4,   0], // LEFT_TOP_6
        [   0, 128, 192,  96,  48,  24,  12,   4,   0, 128], // LEFT_TOP_7
        [ 192, 129,   3,   6,  12,  24,  48,  96, 192, 129], // LEFT_BOTTOM_0
        [ 129,   3,   6,  12,  24,  48,  96, 192, 129,   3], // LEFT_BOTTOM_1
        [   3,   6,  12,  24,  48,  96, 192, 129,   3,   6], // LEFT_BOTTOM_2
        [   6,  12,  24,  48,  96, 192, 129,   3,   6,  12], // LEFT_BOTTOM_3
        [  12,  24,  48,  96, 192, 129,   3,   6,  12,  24], // LEFT_BOTTOM_4
        [  24,  48,  96, 192, 129,   3,   6,  12,  24,  48], // LEFT_BOTTOM_5
        [  48,  96, 192, 129,   3,   6,  12,  24,  48,  96], // LEFT_BOTTOM_6
        [  96, 192, 129,   3,   6,  12,  24,  48,  96, 192], // LEFT_BOTTOM_7
        [ 192, 128,   0,   4,  12,  24,  48,  96, 192, 128], // RIGHT_TOP_0
        [  96, 192, 128,   0,   4,  12,  24,  48,  96, 192], // RIGHT_TOP_1
        [  48,  96, 192, 128,   0,   4,  12,  24,  48,  96], // RIGHT_TOP_2
        [  24,  48,  96, 192, 128,   0,   4,  12,  24,  48], // RIGHT_TOP_3
        [  12,  24,  48,  96, 192, 128,   0,   4,  12,  24], // RIGHT_TOP_4
        [   4,  12,  24,  48,  96, 192, 128,   0,   4,  12], // RIGHT_TOP_5
        [   0,   4,  12,  24,  48,  96, 192, 128,   0,   4], // RIGHT_TOP_6
        [ 128,   0,   4,  12,  24,  48,  96, 192, 128,   0], // RIGHT_TOP_7
        [ 129, 192,  96,  48,  24,  12,   6,   3, 129, 192], // RIGHT_BOTTOM_0
        [   3, 129, 192,  96,  48,  24,  12,   6,   3, 129], // RIGHT_BOTTOM_1
        [   6,   3, 129, 192,  96,  48,  24,  12,   6,   3], // RIGHT_BOTTOM_2
        [  12,   6,   3, 129, 192,  96,  48,  24,  12,   6], // RIGHT_BOTTOM_3
        [  24,  12,   6,   3, 129, 192,  96,  48,  24,  12], // RIGHT_BOTTOM_4
        [  48,  24,  12,   6,   3, 129, 192,  96,  48,  24], // RIGHT_BOTTOM_5
        [  96,  48,  24,  12,   6,   3, 129, 192,  96,  48], // RIGHT_BOTTOM_6
        [ 192,  96,  48,  24,  12,   6,   3, 129, 192,  96], // RIGHT_BOTTOM_7
    ],
    [
        [   0,   0,   0,   0,   0,   0,   0,   0,   0,   0],
        [  31,   0,   0,   0,   0,   0,   0,   0,  31,   0], // A
        [   0,   0,   1,   6,  24,   6,   1,   0,   0,   0], // V
        [  15,  16,   8,   4,   3,   4,   8,  16,  15,   0], // W
        [  31,   0,   0,   0,  31,   0,   0,   0,  31,   0], // m
        [   0,   0,   0,   0,  24,  24,   0,   0,   0,   0], // .
        [   0,   0,   1,   1,   1,   0,   0,   0,   0,   0], // °
        [   0,   0,   0,   0,   0,   0,   0,   0,   0,   0], // -
        [   7,   8,  16,  16,  16,  16,  16,   8,   7,   0], // 0
        [   0,  16,  16,  16,  31,  16,  16,  16,   0,   0], // 1
        [  16,  24,  20,  18,  17,  16,  16,  16,  16,   0], // 2
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
        [  16,  24,  12,   6,   3,   1,   0,   0,  16,  24], // RIGHT_BOTTOM_5
        [   0,  16,  24,  12,   6,   3,   1,   0,   0,  16], // RIGHT_BOTTOM_6
        [   0,   0,  16,  24,  12,   6,   3,   1,   0,   0], // RIGHT_BOTTOM_7
    ],
];
