rcls/monitor/src/tsc.rs

use stm_common::{utils::WFE, vcell::{UCell, VCell}};

///! Pads are +, -, menu.  Note that the index is one less than the enumeration.

/// Rev 1 board had high caps, rev 2 board had low caps.  This value is used to
/// distinguish them.
pub const LO_HI_SEP: u32 = 100;

/// Touch threshold used for low cap boards.
pub const LO_THRESHOLD: u32 = 26;

/// Touch threshold used for hi cap boards.
pub const HI_THRESHOLD: u32 = 1536;

// Little board gives 28..31 and 19..22
// Big board gives 27..30 and 19..20, threhold 22 or 23 would be good.

macro_rules!dbgln {($($tt:tt)*) => {if false {stm_common::dbgln!($($tt)*)}};}

struct State {
    values: UCell<[u32; 3]>,
    complete: VCell<bool>,
}

#[unsafe(link_section = ".noinit")]
static STATE: State = State {
    values: UCell::new([0; 3]), complete: VCell::new(false)};

pub mod pad {
    pub const NONE : u32 = 0;
    pub const PLUS : u32 = 1;
    #[allow(unused)]
    pub const MINUS: u32 = 2;
    pub const MENU : u32 = 3;
}

pub fn init() {
    let gpioa = unsafe {&*stm32u031::GPIOA::ptr()};
    let gpiob = unsafe {&*stm32u031::GPIOB::ptr()};
    let rcc = unsafe {&*stm32u031::RCC::ptr()};
    let tsc = unsafe {&*stm32u031::TSC::ptr()};

    // FIXME - hardwired channels & values.
    if crate::CONFIG.is_lazy_tsc() {
        rcc.AHBENR.modify(|_,w| w.TSCEN().set_bit());
    }

    gpioa.AFRH.modify(
        |_,w| w.AFSEL8().B_0x9().AFSEL9().B_0x9().AFSEL10().B_0x9());
    gpiob.AFRL.modify(|_,w| w.AFSEL0().B_0x9());
    gpiob.AFRH.modify(|_,w| w.AFSEL11().B_0x9());

    // Set open drain mode for the sampling cap pins.
    gpioa.OTYPER.modify(|_,w| w.OT9().B_0x1());
    gpiob.OTYPER.modify(|_,w| w.OT0().B_0x1());

    // Enable AF.
    gpioa.MODER.modify(|_,w| w.MODE8().B_0x2().MODE9().B_0x2().MODE10().B_0x2());
    gpiob.MODER.modify(|_,w| w.MODE0().B_0x2().MODE11().B_0x2());

    // Prescale to 2Mhz.
    let prescaler = match crate::CONFIG.clk {
        2000000 => 0,
        16000000 => 3,
        _ => stm_common::utils::unreachable(),
    };

    // TODO - timings are guesses...
    // Standard pulse range "500ns to 2µs".
    // Use 3 clock = 1.5µs on high and low pulse.
    // Spread-sprectrum on but as low as possible.
    // Max counts is set to 2048, values much below that count as a touch.
    tsc.CR.write(
        |w|w.CTPH().bits(1).CTPL().bits(2)
            .SSD().bits(0). SSE().set_bit().SSPSC().set_bit()
            .PGPSC().bits(prescaler).MCV().B_0x3().TSCE().set_bit());
    // Turning off hysteresis for the cap-sense lines seems to improve
    // sensitivity.
    tsc.IOHCR.write(|w| w.G7_IO2().clear_bit(). G5_IO2().clear_bit());
    // Enable end-of-acquire interrupt.
    tsc.IER.write(|w| w.EOAIE().set_bit());
}

pub fn acquire() {
    // Try + and menu on the first pass (they are physically separate), and
    // then - on the second pass.
    // FIXME - how do we select channels?

    // Minus  = G7IO1
    // CS     = G7IO2
    // Plus   = G7IO3
    // Menu   = G5IO4
    // MenuCS = G5IO2
    STATE.complete.write(false);
    let tsc = unsafe {&*stm32u031::TSC::ptr()};
    // Get + and cap.
    tsc.IOCCR.write(|w| w.G7_IO3().set_bit().G5_IO4().set_bit());
    tsc.IOSCR.write(|w| w.G7_IO2().set_bit().G5_IO2().set_bit());
    tsc.IOGCSR.write(|w| w.G7E().set_bit().G5E().set_bit());
    tsc.CR.modify(|_,w| w.START().set_bit());
}

fn isr() {
    let tsc = unsafe {&*stm32u031::TSC::ptr()};
    let sr = tsc.ISR.read().bits();
    tsc.ICR.write(|w| w.bits(sr));

    let ccr = tsc.IOCCR.read();
    let values = unsafe {STATE.values.as_mut()};
    if ccr.G7_IO3().bit() { // +
        values[0] = tsc.IOG7CR.read().bits();
    }
    if ccr.G5_IO4().bit() { // Menu
        values[2] = tsc.IOG5CR.read().bits();
    }
    if ccr.G7_IO1().bit() { // -
        // We got -, the pass is done.
        values[1] = tsc.IOG7CR.read().bits();
        STATE.complete.write(true);
    }
    else {
        // We did not get -, get - and menu now.
        tsc.IOCCR.write(|w| w.G7_IO1().set_bit());
        tsc.IOSCR.write(|w| w.G7_IO2().set_bit());
        tsc.IOGCSR.write(|w| w.G7E().set_bit());
        tsc.CR.modify(|_,w| w.START().set_bit());
    }
}

/// Return touched pad, 1=+, 2=-, 3=menu, 0=None.
pub fn retrieve() -> (u32, u32) {
    while !STATE.complete.read() {
        WFE();
    }
    // Find the lowest line...
    let mut min_line = 0;
    let values = STATE.values.as_ref();
    let mut min_val = values[0];
    let mut max_val = min_val;
    for (i, &val) in values.iter().enumerate().skip(1) {
        if val > max_val {
            max_val = val;
        }
        else if val < min_val {
            min_val = val;
            min_line = i as u32;
        }
    }
    dbgln!("TSC min {min_val} max {max_val}");

    let threshold = if max_val > LO_HI_SEP {HI_THRESHOLD} else {LO_THRESHOLD};
    let line = if min_val < threshold {min_line + 1} else {0};
    let debug6 = values[0] & 0xff | values[1] << 8 & 0xff00
        | values[2] << 16 & 0xff0000;
    let debug4 = min_val & 0xff | max_val << 8 & 0xff00;
    (line, if super::LCD_WIDTH == 6 {debug6} else {debug4})
}

impl crate::cpu::Config {
    pub const fn lazy_tsc(&mut self) -> &mut Self {
        self.isr(stm32u031::Interrupt::TSC, isr)
    }
    #[allow(dead_code)]
    pub const fn tsc(&mut self) -> &mut Self {
        self.lazy_tsc().clocks(1 << 24, 0, 0)
    }
    pub fn is_lazy_tsc(&self) -> bool {
        self.ahb_clocks & 1 << 24 == 0
    }
}

#[test]
fn check_isr() {
    assert!(crate::cpu::VECTORS.isr[stm32u031::Interrupt::TSC as usize]
        == isr);
}
