rcls/monitor/src/rtc.rs

use crate::CONFIG;

/// Make sure RTC is on, and disable RTC write protect.
pub fn setup_start() {
    let rcc = unsafe {&*stm32u031::RCC::ptr()};

    // RTC enabled and clocked with LSE.  This is only cleared by power on
    // or back-up domain reset.
    rcc.BDCR.modify(|_,w| w.RTCEN().set_bit().RTCSEL().B_0x1());

    unlock();
}

/// Disable write protect.  Note that DPB bit is set in [cpu::init1()].
pub fn unlock() {
    let rtc = unsafe {&*stm32u031::RTC::ptr()};
    rtc.WPR.write(|w| w.bits(0xca));
    rtc.WPR.write(|w| w.bits(0x53));
}

/// Re-enable RTC write protect.
pub fn relock() {
    let rtc = unsafe {&*stm32u031::RTC::ptr()};
    rtc.WPR.write(|w| w.bits(0));
    rtc.WPR.write(|w| w.bits(0));
}

/// Start initialization.
pub fn init_start() {
    let rtc = unsafe {&*stm32u031::RTC::ptr()};

    const {assert!(crate::CONFIG.apb1_clocks & 1 << 10 != 0)}
    const {assert!(crate::CONFIG.low_power)}

    unlock();
    rtc.ICSR.write(|w| w.INIT().set_bit());
    // Polling...
    while !rtc.ICSR.read().INITF().bit() {}
}

pub fn init_end() {
    let rtc = unsafe {&*stm32u031::RTC::ptr()};
    rtc.ICSR.write(|w| w.INIT().clear_bit());
    relock();
}

#[allow(dead_code)]
pub fn set_wakeup(div: u16) {
    let rtc = unsafe {&*stm32u031::RTC::ptr()};

    rtc.CR.write(|w| w.WUTE().clear_bit());
    // This shouldn't take long and there appears to be nothing other than
    // spin that we can do.
    while !rtc.ICSR.read().WUTWF().bit() {
    }

    // Clock input to WUT is LSE / {2,4,8,16}.
    // 32768 / 20 = 1638.4 ≈ 16 * 102.
    rtc.WUTR.write(|w| w.WUT().bits(div));
}

/// Make sure reset is input only.
pub fn ensure_options() {
    let flash = unsafe {&*stm32u031::FLASH::ptr()};

    let options = flash.OPTR.read();
    if options.NRST_MODE().bits() == 1 {
        return;
    }
    crate::debug::banner(
        "Options = 0x", options.bits(), " ... needs to be rewritten");

    // 1.Write KEY1 = 0x4567 0123 in the FLASH key register (FLASH_KEYR)
    // 2.Write KEY2 = 0xCDEF 89AB in the FLASH key register (FLASH_KEYR).
    flash.KEYR.write(|w| w.bits(0x45670123));
    flash.KEYR.write(|w| w.bits(0xcdef89ab));
    // 1.Unlock the FLASH_CR with the LOCK clearing sequence (refer to
    // Unlocking the flash memory ).
    // 2.Write OPTKEY1 = 0x0819 2A3B of the FLASH option key register
    //  (FLASH_OPTKEYR).
    // 3.Write OPTKEY2 = 0x4C5D 6E7F of the FLASH option key register
    // (FLASH_OPTKEYR)
    flash.OPTKEYR.write(|w| w.bits(0x08192a3b));
    flash.OPTKEYR.write(|w| w.bits(0x4c5d6e7f));

    // Write the options...
    flash.OPTR.modify(|_,w| w.NRST_MODE().B_0x1());

    while flash.SR.read().BSY1().bit() {}
    flash.CR.write(|w| w.OPTSTRT().set_bit());
    while flash.SR.read().BSY1().bit() {}

    crate::debug::write_str("Options written!\n");
}

pub fn get_cal() -> i32 {
    let rtc = unsafe {&*stm32u031::RTC::ptr()};
    let calr = rtc.CALR.read();
    calr.CALM().bits() as i32 - calr.CALP().bit() as i32 * 512
}

pub fn set_cal(cal: i32) {
    let rtc = unsafe {&*stm32u031::RTC::ptr()};
    unlock();
    rtc.CALR.write(
        |w| w.CALP().bit(cal & 512 != 0).CALM().bits(cal as u16 & 511));
    relock();
}

pub fn standby(update_pupd: bool) -> ! {
    let pwr   = unsafe {&*stm32u031::PWR  ::ptr()};
    let rcc   = unsafe {&*stm32u031::RCC  ::ptr()};
    let gpioa = unsafe {&*stm32u031::GPIOA::ptr()};
    let gpiob = unsafe {&*stm32u031::GPIOB::ptr()};
    let gpioc = unsafe {&*stm32u031::GPIOC::ptr()};
    let scb   = unsafe {&*cortex_m::peripheral::SCB::PTR};

    // Low power mode to use is standby...
    pwr.CR1.modify(|_,w| w.LPMS().bits(3)); // 3=Standby, 4=Shutdown.

    // Clear the reset causes & set restart MSI.
    rcc.CSR.write(
        |w| w.RMVF().set_bit().MSISRANGE().bits(crate::cpu::MSIRANGE));

    fn pupd(shift: u32, gpio: &stm32u031::gpioa::RegisterBlock,
            pucr: &stm32u031::pwr::PUCRA, pdcr: &stm32u031::pwr::PDCRA) {
        let standby_pu = (CONFIG.standby_pu >> shift) as u32 & 0xffff;
        let standby_pd = (CONFIG.standby_pd >> shift) as u32 & 0xffff;
        let keep_up    = (CONFIG.keep_pu    >> shift) as u32 & 0xffff;
        let keep_down  = (CONFIG.keep_pd    >> shift) as u32 & 0xffff;

        let keep = keep_up | keep_down != 0;
        // Not that if we haven't bought the pin out of default mode then IDR
        // doesn't reflect the pin.
        let bits = if keep {gpio.IDR().read().bits()} else {0};
        if standby_pu | keep_up != 0 {
            pucr.write(|w| w.bits(bits & keep_up | standby_pu));
        }
        if standby_pd | keep_down != 0 {
            pdcr.write(|w| w.bits(!bits & keep_down | standby_pd));
        }
    }

    if update_pupd {
        pupd( 0, gpioa, &pwr.PUCRA, &pwr.PDCRA);
        pupd(16, gpiob, &pwr.PUCRB, &pwr.PDCRB);
        pupd(32, gpioc, &pwr.PUCRC, &pwr.PDCRC);
    }

    crate::debug::flush();

    // Deep sleep.  Note that if an interrupt does WFE after this we are liable
    // to go into standby from the ISR!
    unsafe {scb.scr.write(4)};

    // It looks like, if we do have wake-up bits set, then we reset immediately,
    // instead of ignoring the WFE completely.  The event flag is probably set
    // when we get here.
    loop {
        #[cfg(target_os = "none")]
        cortex_m::asm::wfi();
        unsafe {(*cortex_m::peripheral::SCB::PTR).aircr.write(0x05fa0004)};
    }
}

impl crate::cpu::Config {
    pub const fn rtc(&mut self) -> &mut Self {
        self.low_power = true;
        self.apb1_clocks |= 1 << 10;
        self
    }
}
