rcls/monitor/src/clocky32.rs

#![cfg_attr(target_os = "none", no_std)]
#![cfg_attr(target_os = "none", no_main)]
#![allow(internal_features)]
#![allow(unpredictable_function_pointer_comparisons)]
#![feature(const_default, const_trait_impl, derive_const)]
#![feature(link_llvm_intrinsics)]

mod clocky;
mod cpu;
mod debug;
mod ens212;
mod ens220;
mod i2c;
mod lcd;
mod rtc;
mod tmp117;
mod tsc;
mod utils;

const LCD_WIDTH: u32 = 4;

use clocky::{CONFIG, DEBUG_ENABLE, I2C_LINES, debug_fmt, main};
