rcls/monitor/(commit log)

2025-05-24 Monitor board layout
    [monitor.kicad_pcb, monitor.kicad_sch]
2025-05-24 Footprint tweaks.
    [monitor.kicad_pcb]
2025-05-24 Manufacturing updates
    [monitor.kicad_pcb, monitor.kicad_sch]
2025-05-24 Robustify reset
    [monitor.kicad_pcb, monitor.kicad_sch]
2025-05-27 Second board layout routed.
    [clocky.kicad_pcb, clocky.kicad_sch, monitor.kicad_sch]
2025-05-27 DRC passes.
    [clocky.kicad_pcb, clocky.kicad_sch]
2025-05-27 Sort the touch pads out a bit.
    Zones still need work.
    [clocky.kicad_pcb, clocky.kicad_sch]
2025-05-27 Update monitor for actual display
    [monitor.kicad_pcb, monitor.kicad_sch]
2025-05-27 Do a round of DRC and tidy-up.
    [monitor.kicad_pcb]
2025-05-28 Do a round of tidy-up on clocky.
    [clocky.kicad_pcb, clocky.kicad_sch]
2025-05-29 Rotate CPU on clocky. Tidy up every where.
    [clocky.kicad_pcb, clocky.kicad_sch]
2025-05-29 Tweak power & zones.
    [clocky.kicad_pcb, clocky.kicad_sch]
2025-05-29 Use a 2.54mm connector footprint.
    [monitor.kicad_pcb, monitor.kicad_sch]
2025-05-29 Filter ADC input.
    Tweak other capacitors.
    [monitor.kicad_pcb, monitor.kicad_sch]
2025-05-30 Final updates. Ordered.
    [clocky.kicad_pcb, clocky.kicad_sch, monitor.kicad_pcb, monitor.kicad_sch]
2025-06-23 First cut of some code
    [monitor.kicad_sch]
2025-06-30 I2C error handling. Power.
    [debug.rs, decimal.rs, font.rs, i2c.rs, monitor.rs, oled.rs]
2025-07-03 Blinky for clocky
    [clocky.kicad_sch]
2025-07-06 Big update to the monitor.
    Accell, low side current sense.
    [clocky.kicad_sch, monitor.kicad_pcb, monitor.kicad_sch]
2025-07-06 Switch to the 2-stage sense amp.
    [monitor.kicad_pcb, monitor.kicad_sch]
2025-07-06 Board layout updated.
    [monitor.kicad_pcb, monitor.kicad_sch]
2025-07-07 Tweaks. Fabbing.
    [clocky.kicad_pcb, clocky.kicad_sch, monitor.kicad_pcb, monitor.kicad_sch]
2025-07-09 Update the python scripts.
    [monitor.kicad_pcb, monitor.kicad_sch]
2025-07-09 Factor out a heap of interrupt table set-up.
2025-07-11 Low power blinky
2025-07-11 Don't spin draining the UART.
2025-07-12 Factor out the power & standby handling
2025-07-21 Update notes on schematic.
    [clocky.kicad_sch]
2025-07-24 More split out.
    Reduce binary size by avoiding format!s.
    [clocky.rs, clocky32.rs, clocky48.rs, cpu.rs, debug.rs, lcd.rs, rtc.rs, tmp117.rs]
2025-07-26 Work flow simplification.
2025-07-31 Tidy and bug fix.
    [adc.rs, decimal.rs, monitor.rs]
2025-08-01 Tweak ADC start-up.
2025-08-01 Manky calibration code. Manky accel handling.
2025-08-02 Get accel hooked in sensibly & implement screen flip.
    [adc.rs, cpu.rs, debug.rs, fxls8971.rs, i2c.rs, monitor-discrete.rs, monitor-hall.rs, monitor.rs]
2025-08-03 Update resistor values.
    [clocky.kicad_sch]
2025-08-03 Make temp the default display; it's useful on an unconfigured device.
2025-08-14 Add clock drive and crash address.
    [clocky.kicad_sch]
2025-08-16 Simplify and fix and temperature handling.
    [clocky.kicad_sch]
2025-08-16 Correct handling of weekday.
    [rtc.rs]
2025-08-29 Fix no-debug.
    Update offset.
    [clocky.rs, debug.rs, monitor-discrete.rs]
2025-10-26 Update schematic with pressure and humidity.
    [clocky.kicad_sch]
2025-10-27 Update PCB layout. Song and dance with Kicad breaking footprints...
    [clocky.kicad_pcb, clocky.kicad_sch]
2025-10-28 Manufacturing updates.
    [clocky.kicad_pcb, clocky.kicad_sch]
2025-11-27 Sync up I2C.
2025-11-27 Put in states for pressure / humidity.
    Wrappers & free up some RTC state space.
2025-11-27 Add a random voltage regulator.
2025-11-28 Fix the double wait!
    [i2c.rs, tmp117.rs]
2025-11-28 Pressure handling
2025-11-29 Pressure position.
    Various refactoring. And blink when ext-osc is on.
2025-11-29 Put the ENS212 into low power mode.
    Minor tweaks.
2025-11-30 Fix a silly typo.
    Rename 'scract' to 'touch_debug'
    [clocky.rs, tsc.rs]
2025-12-01 Update board with 1.8V power domain.
    [clocky.kicad_pcb, clocky.kicad_sch]
2025-12-03 Tweak a component.
    [clocky.kicad_pcb, clocky.kicad_sch]
2025-12-03 Typecheck filter_pos.py
2025-12-04 I2C and debug go to common code
2025-12-04 We only need one I2C context...
    Get rid of some wildard uses.
2025-12-06 Cratify I2C.
2025-12-07 Track I2C.
2025-12-15 Fix the pressure DP with 6 digits.
    [clocky.rs, cpu.rs]
